robertsaabwoo/ttsky-analog-equalizer/docs/info.md

## How it works

This is a fully analog **600 Mb/s receiver front end**: an equalizer that undoes the loss of the chip's own
analog input path, followed by a clock-recovery loop that locks an on-chip oscillator to the incoming data
stream. There is no reference clock anywhere on the chip — the output clock is generated from the data itself,
which is why `clock_hz` is 0 and the harness `clk` pin is unused.

The signal path is `ua[0]/ua[1] -> CTLE -> CDR -> inverter chains -> uo[0]/uo[1]`, drawn in
`xschem/ctle_cdr_rx.sch`.

### 1. The CTLE (`xschem/CTLE.sch`)

A continuous-time linear equalizer: a differential pair with resistively and capacitively degenerated sources.
The degeneration network puts a zero below the data's Nyquist frequency, so the stage's gain *rises* with
frequency and cancels a channel that rolls off.

The channel it has to cancel is not an external cable — it is the **Tiny Tapeout analog pin path itself**,
which is specified at under 500 Ω of series resistance and under 5 pF of pad capacitance. That is a pole at
about 64 MHz, well below the 300 MHz Nyquist frequency of 600 Mb/s data, and it costs roughly 13.7 dB at
Nyquist. In simulation a 200 mV differential input arrives at the CTLE as only **64 mV** — the eye is
essentially shut at the pad before any circuit has touched it. The CTLE is therefore load-bearing, not an
optimization: it contributes about **+13.5 dB at Nyquist**, which very nearly exactly cancels the pin path.

### 2. The CDR (`xschem/CDR.sch`)

A reference-less **bang-bang (Alexander) clock-and-data-recovery loop**:

- an **Alexander phase detector** — four differential D flip-flops (eight `d_latch` stages) and two XORs —
  samples the equalized data on both clock edges and reports only whether the clock is *early* or *late*;
- that early/late decision drives a **charge pump** into a **loop filter**, producing a control voltage
  `vctrl`;
- `vctrl` tunes a **five-stage differential ring oscillator**, whose output is fed back to the phase detector
  as the sampling clock.

The loop settles when the oscillator runs at exactly the data rate with its edges centred in the data eye.
Because the phase detector is phase-only, the loop filter is deliberately about 10× smaller than a
comparable PLL's — a bang-bang CDR legitimately wants the higher loop bandwidth, and with PLL-sized
capacitors the control voltage drifts past the oscillator's usable range before the loop can acquire.

A small **startup precharge cell** (`xschem/vctrl_precharge.sch`) seeds `vctrl` into the oscillator's active
region for the first ~130 ns after power-up and then electrically removes itself. Without it, roughly half of
all power-ups never acquired lock — the outcome depended on the incoming data's polarity at power-on. The
seed is generated by a scaled replica of the ring oscillator's own tail device, so it tracks the oscillator
over process, voltage and temperature instead of being a hard-coded voltage.

### 3. Output buffering

Both recovered clock phases are buffered to pads through tapered inverter chains. The second phase on `uo[1]`
is not decorative: driving only one leg of a differential ring oscillator loads it asymmetrically.

Note that `uo[1]` is an *inverted and delayed* copy of `uo[0]`, not a true differential complement — it is
generated by passing the recovered clock through an inverter, so it carries that inverter's delay and
threshold offset. In simulation the two phases sum to the supply on average, but they have noticeably
different duty cycles (roughly 33 % and 61 % high). Do not build anything that assumes a 50 % duty cycle on
either output, or that the two are exactly non-overlapping.

### Simulated performance

Verified end to end (`xschem/tuning/e2e_ctle_cdr_tb.spice`) with data driven through a worst-case
500 Ω / 5 pF model of the analog pin path, at tt / 27 °C / 1.8 V. Section numbers refer to the design log
`xschem/tuning/ctle/NOTES_CTLE.md` (§C…) and `xschem/tuning/NOTES.md` (§…).

| quantity | value | source |
|---|---|---|
| data rate | 600.6 Mb/s (UI 1.665 ns) | §14 |
| recovered clock frequency | 600.64 MHz — a **full-rate** clock, one cycle per bit | §C23 |
| `vctrl` when locked | 0.791 V, the same point the CDR reaches alone (0.792 V) | §C23, §17e |
| signal at the CTLE input (after the pad) | 64 mV differential — the eye is shut at the pad | §C23 |
| signal at the CTLE output | 299 mV differential | §C23 |
| recovered clock swing | rail to rail (1.870 V) | §C23 |
| CTLE eye, worst PVT corner (ss / 125 °C / 1.62 V) | 174 mV, 0.350 UI | §C22 |
| combined channel + CTLE at Nyquist, 27 corners | −2.03 … +0.66 dB | §C18 |
| recovered clock period jitter, CDR alone on ideal data | 0.68 % UI RMS, 2.5 % UI pk-pk | §16b |
| recovered clock period jitter, full chain on PRBS7 | 18.45 ps RMS = 1.11 % UI; 6.70 % UI pk-pk | §C27 |
| sampling-phase error vs the ideal bit grid | 199 ps RMS = 11.96 % UI; 77 % UI pk-pk | §C27 |
| eye remaining at the sampling instant, nominal corner | mean 181 mV; 13 of 1201 samples within 25 mV of threshold | §C27 |
| startup precharge over 45 PVT corners | 45/45 pass, release 136-167 ns | §20a |

Those figures are for an alternating 0101 input, the easiest pattern for a bang-bang phase detector because
every bit is a transition. On a PRBS7 pattern — half the transition density, and runs of up to seven identical
bits — the loop still acquires, but it takes about **3× longer** (roughly 3 µs rather than 1 µs), overshoots
its final control voltage by ~37 mV on the way, and settles with ~2.8× the residual control-voltage ripple
(93.8 mV versus 33.7 mV). This is inherent to a bang-bang loop rather than a defect: each phase-detector
decision moves the control voltage by a fixed step (~17 mV here), and during a run of identical bits there are
no transitions, so the loop is briefly blind and phase error accumulates before it can be corrected. (§C25-B,
§C25-E)

Input amplitude matters: 200 mVpp differential at the pad is comfortable, and at 100 mVpp the signal path
still scales linearly but the loop wanders ±40 mV about its lock point. 100 mVpp should not be quoted as the
sensitivity limit — the actual limit has not been found. (§C25-D)

**Known limitations:**

- The ring oscillator cannot reach 600 MHz at 125 °C, or at a 1.62 V supply. The design is intended for room
  temperature and a nominal 1.8 V supply; this limit is characterised and accepted rather than fixed. (§20b)
- **Sampling-phase margin is thin.** §C27 measured it: phase error against the ideal bit grid is 0.120 UI
  RMS, against the ±0.175 UI of margin the 0.350 UI worst-corner eye allows — the eye edge is only about
  1.46σ away. At the nominal corner, 13 of 1201 samples land within 25 mV of the decision threshold. The
  loop frequency-locks exactly (0.011 %) with no cycle slips, so this is a margin question, not a
  functional one, but it is the risk that decides the link. The mechanism is the residual control-voltage
  ripple: 93.8 mV pp on a 357 MHz/V oscillator is ±16 MHz of instantaneous frequency.
- **Phase error at the worst PVT corner has not been measured**, only at nominal. That run — ss / 125 °C /
  1.62 V, where the eye is 0.350 UI rather than wide open — is the one that would decide whether this
  design closes. (§C27)
- **No PVT on the combined loop, and no layout**, so no extracted parasitics and no post-layout simulation.

## How to test

On hardware:

1. Hold `ua[2]` (`vbias`) at a steady **0.9 V**. A bench supply or a clean resistor divider is fine; it draws
   almost no current.
2. Drive `ua[0]` / `ua[1]` with a **differential 600 Mb/s** signal — a PRBS pattern or an alternating 0101
   pattern both work — with a common mode of about **0.9 V** and a swing of roughly **200 mV differential**.
   Keep the swing **below about 400 mVpp**: the input pair compresses above that, and a compressed input
   cannot be equalized.
3. Watch `uo[0]` on a scope or a fast counter. When the loop is locked it is a rail-to-rail square wave at the
   **bit rate** — about **600 MHz** for 600 Mb/s data, since this is a full-rate CDR. `uo[1]` should be its
   inverse, at the same frequency but not the same duty cycle.
4. Expect lock within a few microseconds of power-up: in simulation the loop settles in ~1 µs on a 0101
   pattern and ~3 µs on PRBS7, and it does not depend on which polarity the data happens to be in when the
   supply comes up (§C25-B, §C25-C).

Sweeping the input data rate slowly around 600 Mb/s and watching where `uo[0]` stops tracking maps out the
loop's lock range. Because the oscillator's reach is the limiting factor, expect that range to narrow as the
die heats up.

In simulation, the decks under `xschem/tuning/` reproduce all of the above; `e2e_ctle_cdr_tb.spice` is the
full chain and `xschem/tuning/ctle/` holds the equalizer-only AC, eye and PVT decks. All of them must be run through
`xschem/tuning/safe_ngspice.sh`, which caps memory and wall-clock time.

## External hardware

- A differential pattern generator (or two synchronized single-ended sources) capable of 600 Mb/s for
  `ua[0]` / `ua[1]`.
- A stable ~0.9 V bias reference for `ua[2]`.
- An oscilloscope with at least ~1 GHz of bandwidth, or a frequency counter, on `uo[0]`.
