robertsaabwoo/ttsky-analog-equalizer/(commit log)

2026-04-05 using custom VCO
    [CDR.sch, CDR_tb.sch, diff_amp_inv.sch, ring_inverter.sch, ring_oscillator.sch, ring_oscillator_tb.sch]
2026-04-05 slightly better
    [ring_inverter.sch]
2026-04-13 tuned closer to 300 MHz
    [CDR.sch, CDR_tb.sch, d_latch.sch, diff_amp_inv.sch, ring_inverter.sch, ring_oscillator.sch, ring_oscillator_tb.sch]
2026-07-21 Checkpoint: CDR sandbox locks in sim with 10x-shrunk (fake) loop-filter caps
    Preserves the first configuration where the bang-bang CDR loop frequency-locks
    in transient simulation: clk+ = 600.6 MHz, -0.02% vs the 600.6 MBaud data,
    rail-to-rail complementary clock, PD producing real bang-bang decisions,
    vctrl settling at 0.792 V.
    IMPORTANT — this locks ONLY because the loop-filter caps are 10x-shrunk
    (cap1 L=6->0.6, cap2 W=11->1.1), the sim-speed trick from NOTES.md §10. This
    is NOT a manufacturable configuration. With real (full-size) caps the loop
    FAILS TO ACQUIRE: from cold-start vctrl bleeds through the VCO dead-zone cliff
    (~0.65 V) before the phase-only Alexander PD can acquire, the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
    [CDR_tune.sch, CDR_tune_tb.sch, alexander_phase_detector_tune.sch, d_flip_flop_tune.sch, d_latch_tune.sch, diff_amp_inv_tune.sch, inverter_buffer_tune.sch, ring_inverter_tune.sch]
2026-07-22 Document §15: real-cap acquisition fails; root cause is architectural
    Source-follower clamp abandoned (run_A Rbot L=12: gate 1.225V -> vctrl
    collapsed to 0.53V, VCO dead). Near-vertical transfer, no manufacturable
    landing in the 0.65-0.9V window.
    Root cause: PLL blocks repurposed as a CDR deleted the reference+divider+PFD
    frequency-acquisition path. Bang-bang PD is phase-only. No reference clock is
    available (user-confirmed reference-less), so the tiny_pll PFD cannot be reused.
    Direction: validate the shrunk loop-filter caps as the legitimate CDR retune
    via a jitter measurement (§16, running overnight).
    [ring_inverter_tune.sch, tiny_pll_loop_filter_cap1_tune.sch, tiny_pll_loop_filter_cap2_tune.sch]
2026-07-22 Set shrunk-cap + R=23 config for jitter study (§16 branch)
    cap1 L=6->0.6, cap2 W=11->1.1 (10x shrink, §10 speed trick), ring R 23.5->23
    (proven §14 600.6 MHz lock point). This is the config whose jitter we validate
    to decide whether the shrunk caps are the legitimate CDR retune.
    [ring_inverter_tune.sch, tiny_pll_loop_filter_cap1_tune.sch, tiny_pll_loop_filter_cap2_tune.sch]
2026-07-22 §16: shrunk-cap jitter is small (0.68% UI RMS) — locks dead-on at 600.6 MHz
    Bang-bang hunting jitter on ideal 0101 data: 11.27 ps RMS (0.68% UI),
    41.12 ps pk-pk (2.47% UI), freq 600.616 MHz (+0.003%). Two-state limit-cycle
    dither, not numerical noise. Shrunk caps look like a legitimate CDR retune.
    Remaining threat: CID (0101 pattern has no transition runs). Add analyze_jitter.py
    (pure-stdlib jitter extractor from wrdata dumps). CID stress test next.
2026-07-22 §16e/f: shrunk caps PASS CID stress (runs 5/10/15 UI, never lose lock)
    During no-transition runs the VCO coasts <=1% off, vctrl drifts <20mV UPWARD
    (safe, away from the 0.65V cliff), loop recovers to 600.4 MHz within ~90 cycles.
    Shrunk caps validated as legitimate CDR retune (jitter + CID both pass).
    §16f watch item: cold-start acquisition is sensitive to the t=0 data seed (first
    CID attempt failed to acquire with opposite .op polarity). Polarity robustness
    test queued. Add cid_analyze.py.
2026-07-22 §16g: polarity test FAILS — cold-start acquisition depends on power-up polarity
    Opposite .op seed (vin+ starts HIGH): loop never acquires, vctrl stuck ~18uV,
    VCO dead the whole 1200ns. Only difference from the locking run is the polarity,
    so it's a real effect. Shrunk caps fix cap-size + pass jitter/CID, but cold-start
    is not polarity-robust (~50% power-up fail risk) -> a polarity-independent startup
    aid (precharge) is warranted even with shrunk caps. Ran safely under safe_ngspice.sh
    (no crash). Validating precharge fix next (§16h).
2026-07-22 §16h: precharge fix VALIDATED — vctrl startup seed makes cold-start polarity-independent
    Bad-polarity netlist + .ic v(x1.net1)=0.79 -> locks at 600.68 MHz (vctrl holds
    0.792, clk+ rail-to-rail). Seeding vctrl above the 0.65V cliff at power-up removes
    the polarity dependence. Complete session-6 picture: (1) architectural root cause,
    (2) shrink caps for cap-size acquisition (jitter+CID pass), (3) startup precharge
    for polarity-independent cold start. Remaining: build the real precharge one-shot.
2026-07-23 §17: add vctrl_precharge_tune — real POR one-shot startup precharge cell
    Replaces the §16h `.ic v(x1.net1)=0.79` proof-of-concept with an actual
    circuit, and instantiates it on the vctrl node in CDR_tune.
    Topology (9 devices):
    R1 (686k xhigh_po) + MCPOR (8x8 nfet gate cap) RC power-on ramp on nrc
    INV_A (nrc->pre), INV_B (pre->preb) one-shot, HIGH during hold
    MBP (enabled pfet source) + MBD (diode nfet) nbias = Vgs(MBD) ~ 0.79 V
    MSW (8/0.6 nfet) holds vctl at nbias
    MBD is a scaled replica of the ring tail M5, so the seed voltage tracks the
    VCO dead-zone cliff (~0.65 V) over PVT instead of being a fixed number.
    MSW opens before the b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
    [CDR_tune.sch, vctrl_precharge_tune.sch]
2026-07-23 §17e: real precharge cell VALIDATED in-circuit — bad polarity now locks at 600.631 MHz
    The exact §16g failing case, with the real vctrl_precharge_tune cell and NO seed
    on vctrl (only .ic on the POR cap, which is genuinely discharged at power-up):
    §16g bare loop vctrl 18 uV clk+ 6 mV never acquires
    §16h .ic v(vctrl)=0.79 vctrl 0.7921 clk+ 1.875 V 600.68 MHz (concept)
    §17 real cell vctrl 0.7918 clk+ 1.876 V 600.631 MHz <- PASS
    Cell seeds vctrl to 0.803 V, releases at 126.5 ns, loop then pulls to its own
    lock point 0.792 V and holds -- the loop wins after release, which is exactly
    what the §15 source-follower clamp could not do.
    Co-Author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
2026-07-23 §18: add PVT test suite for the precharge cell — built, not run
    xschem/tuning/pvt/ : gen_pvt.py + run_pvt.sh + collect_pvt.py + README.md.
    63 decks across three tiers, generated from the schematics (so they cannot
    drift) and gitignored. Nothing is executed by default.
    T0 ring open-loop f(vctrl) curve 11 decks ~12 min
    T1 cell alone, supply ramp, no .ic 45 decks ~8 min
    T2 full loop, bad polarity 7 decks ~2 h HEAVY
    Rationale for the split: the cell's hold level is a Vgs of the M5-replica diode
    and is designed to TRACK the dead-zone cliff, while t_rel is an R*C that tracks
    nothing and only has to stay in a window -- different tests break them. T0 exists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
2026-07-23 §19: fix CDR_tune_tb for GUI runs — .ic for the POR, save-limited raw, graphs
    The GUI testbench produced a dead clock (~5 mV swing) after §17 added the
    precharge cell. Cause: .op treats a cap as an OPEN, so the POR node nrc solved
    to Vdd, `pre` stayed 0, the one-shot never fired and vctrl seeded at 0.6634 V --
    exactly on the ~0.65 V dead-zone cliff. No oscillation -> no clock edges -> no
    PD output -> vctrl frozen. Reproduced: vctrl pp 4.4 uV, clk_pp 6.096 mV.
    This is the GOOD polarity, which locked WITHOUT a precharge in §16b: adding the
    cell moved the DC operating point onto the cliff via MSW's subthreshold path to
    nbias. So .ic is now mandatory for this deck -- a sim artifact (silico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
    [CDR_tune_tb.sch]
2026-07-23 §20: T0+T1 PVT results — cell passes 45/45; ring temperature limit ACCEPTED
    Ran both cheap tiers (T2, ~2 h, still not run).
    T1 precharge cell: 45/45 PASS. Seed 0.693-0.908 V, release 136-167 ns, across
    MOS {tt,ss,ff,sf,fs} x T {-40,27,125} x VDD {1.62,1.80,1.98} x RC {typ,hh,ll},
    self-starting from a real supply ramp with no .ic anywhere. The M5-replica bias
    does track the cliff as designed. t_rel is far more stable than expected (±10%)
    because MCPOR is a MOS gate cap, so the PDK cap corners do not touch it.
    Tightest margin is 31 mV at ff/-40C, with a caveat about T0's coarse resolution.
    T0 VCO tuning range: 6 pass / 5 fail. At 125C the curve saturates above 0.85 V,
    so the ring is RC-l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
2026-07-23 CTLE §C1-C10: characterize the CTLE and retune it into a real equalizer
    The block as drawn is not an equalizer. Its degeneration zero (~790 MHz, set
    by a 597 ohm res_high_po against 338 fF) lands on top of its own output pole,
    so the two cancel and CTLE.sch is a flat 10.35 dB differential amplifier with
    +0.00 dB of boost. Confirmed CTLE.sch is byte-identical on all seven branches
    and has one commit ever, so there is no better variant to recover.
    Retune, in the sandbox copy CTLE_tune.sch:
    - the two degeneration MIM caps (13x13 each, to the tail) become ONE 18x18
    cap bridging the two source nodes. Differentially that is 2C per side for
    half the area -- 4x the area efficiency, 1.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
    [CTLE_tune.sch, CTLE_tune_tb.sch]
2026-07-23 CTLE §C10-C14: boost ladder, 1 Gb/s, and the chain interface check
    Boost ladder (ladder.spice, 48 sizings x 3 channels in one AC run; eye3.spice,
    9 sizings x 3 channels in eyes). Two results:
    - There is a ceiling. This topology supplies at most ~5-6 dB of boost, so a
    channel losing more than ~6 dB at Nyquist cannot be flattened by one stage,
    only softened. The 4 pF channel (11.8 dB at Nyquist) bottoms out at ~4 dB
    of residual ripple no matter how it is sized.
    - The ranking inverts with channel loss, so the sizing is a real choice, and
    C10 is now an answer table: mild channel -> Ldeg 1.5 / Wcap 18 (what
    CTLE_tune.sch holds); unknown channel -> Ldeg 3.0 / Wcap 21 i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
    [subckt_src.sch]
2026-07-23 CTLE: PVT-qualify the minimax sizing too, so switching needs no re-run
    ac_corner_mm.spice runs Ldeg 3.0 / Wcap 21 over the same 27 corners as the
    primary sizing: DC gain +6.93..+8.34 dB, boost +4.35..+5.97 dB, gain at Nyquist
    +8.04..+11.40 dB. Equally PVT-stable; it just over-equalizes the mild 1 pF
    channel on purpose. Both candidate sizings are now qualified, so choosing
    between them is a channel question only.
2026-07-24 CTLE §C15-C21: the channel is the TT pin — retune against 500Ω/5pF
    The blocking question from §C14 is answered: the channel is not external, it
    is the Tiny Tapeout analog pin path itself, spec'd at <500 Ω and <5 pF.
    That bound puts the pole at 63.7 MHz, 4.7x below Nyquist, and at 600 Mb/s the
    eye is FULLY CLOSED at the pad (-5 mV, 0.000 UI). Every channel measured up to
    §C14 was milder than the guaranteed worst case, so the old sizing was tuned for
    the wrong thing — on the real channel it recovers only 46 mV / 0.090 UI.
    Retuned to Win 20 / Lload 20 / Ldeg 5.0 / Wcap 18: 232 mV / 0.430 UI on the
    spec-worst channel, 5x the height and 4.8x the timing margin, at the same MIM
    area and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
    [CTLE_tune.sch]
2026-07-24 HANDOFF §6: point at the TT-pin channel result and the final CTLE sizing
2026-07-24 CTLE §C22: run the eye at the PVT extremes, not just AC
    C18 qualified the corners in AC only. The actual PRBS7 eye at ss/125C/1.62V is
    174 mV / 0.350 UI -- it never closes, and 0.350 UI is the number the rest of the
    chain should be designed against.
    Also exposes that the output common mode moves 362 mV over the corner box, which
    D2S_amp is DC-coupled to and has never been checked against.
    Records a trap that silently invalidated the first attempt: ngspice's 'reset'
    discards instance 'alter's but keeps 'alterparam', so a corner loop using
    'set temp'/'alter VDD' returned identical numbers for every corner with no
    warning.
2026-08-02 main: archive sim tools/decks + STATUS note; gitignore sim outputs
    Bring loose infrastructure onto main alongside the fast-forwarded CDR work
    (§16-20): the check_swing.sh / jitter.py tools, the baseline sim decks, the
    xschem design README, and a STATUS.md documenting the new branch layout and
    the fact that the promoted real design files still carry pre-validation tuning
    (the validated design lives in tuning/; stale hand-edits were stashed).
2026-08-02 main: archive pre-sandbox scratch/reference schematics
    Non-empty experimental and reference schematics from before the tuning/ sandbox
    era (the original tiny_pll blocks the CDR was derived from, early testbenches,
    inverter/latch experiments). Kept for history. Excluded deliberately: empty
    68B templates (untitled.sch, demux_tbsch, alexander_single.sch) and the
    abandoned LA_Limiter (see xschem/STATUS.md).
    [CDR_single.sch, TSPC_Latch.sch, demux_tb.sch, diff_savefile.sch, double_inverter.sch, full_tb.sch, inverter_buffer.sch, just_in_case.sch]
2026-08-02 CTLE §C23: end-to-end CTLE+CDR locks through the pad LPF (merge gate)
    First simulation of the CTLE and CDR as one loop. 200 mVpp diff data through the
    500ohm/5pF TT pad LPF on both legs -> CTLE_tune -> CDR_tune. The pad crushes the
    eye to 64 mV; the CTLE equalizes it back to 299 mV diff; the CDR locks at
    600.64 MHz / vctrl 0.791 V (= the standalone lock point), rail-to-rail recovered
    clock. Physics closes: ~13.5 dB CTLE gain vs ~13.7 dB channel loss at Nyquist.
    Subckts harvested from a FRESH CDR_tune_tb.sch netlist (the stale untracked one
    lacked the x20 precharge + variant-E clock). Open before merge: measure rclk-,
    both polarities, PRBS/CID through the CTLE, PVT. See NOTES_CTLE §C23.
    C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
2026-08-15 Promote the validated CDR+CTLE into the real design, and wire it to TinyTapeout
    The tuning/ sandbox has been the real design since NOTES 14/16/17 and
    NOTES_CTLE C17/C20/C23; the files at xschem/*.sch were still the known-wrong
    300 MHz plan from c9ee560. This promotes every validated block into its real
    name and rewires the project around it.
    Promotion (verified at NETLIST level, not by eye): CDR.sch was re-netlisted and
    compared against the validated tuning/e2e_blocks.inc -- all 17 leaf subcircuits
    match exactly, with an identical top-level instance list. Every promoted block
    was checked to be pin-identical first, so each was a wholesale file copy plus a
    rewrite of the internal *_tune.sym r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
    [CDR.sch, CTLE.sch, ctle_cdr_rx.sch, ctle_cdr_rx_lvs.sch, d_latch.sch, diff_amp_inv.sch, inverter_buffer.sch, ring_inverter.sch]
2026-08-15 project.v: fix power-pin direction on the ctle_cdr_rx blackbox
    verilator caught it: the blackbox declared VDPWR/VGND as inout while the TT
    top module receives them as input, which is an ASSIGNIN error. Lints clean now.
    [project.v]
2026-08-15 Move to a 2x2 tile, and stack the C25 end-to-end batch to run unattended
    Tile: the promoted design is ~166 transistors plus 43 long poly resistors
    (res_high_po L=20-23 um each) and a MiM cap. 1x2 (161 x 225.76 um) was chosen
    back when this was the CTLE->latch chain and is now too tight, so info.yaml and
    mag/Makefile move to 2x2 (334.88 x 225.76 um). The .def itself stays out of git
    (mag/.gitignore ignores *def); the Makefile has the wget rule.
    Three traps found while doing it, all written into mag/README.md:
    - the 1x2 and 2x2 .def files are IDENTICAL except for DIEAREA and the
    standard-cell ROWs. Same pins, same positions. So `make start` draws the
    same frame either way and the .m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
2026-08-15 Measure the actual area budget: 1162 um2 drawn, so area was never the constraint
    Flattened the ctle_cdr_rx netlist: 216 transistors, 43 poly resistors, 1 MiM
    cap, 1162 um2 of drawn device area. Even at a 5x hand-layout multiplier that is
    ~5800 um2 against 36 347 um2 in a 1x2 tile.
    This contradicts the 'plausible but tight' framing I gave when proposing the
    move to 2x2 -- 1x2 would have fit with room to spare. 2x2 still stands on
    layout comfort (matched ring placement, guard rings, routing channels), but
    mag/README.md now records that it is a comfort choice, not a necessity, and
    that reverting is a two-line change.
    Also records what actually shapes the floorplan rather than the area total: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
2026-08-15 Correct the CDR.sym pin-change assessment, and write a real root README
    The vbias pin change was assumed to have made full_tb.sch and demux_tb.sch
    stale. Checked properly: it did not. The six pre-existing pins sit at IDENTICAL
    coordinates in the old and new symbol -- only the listing order in the file
    differs -- and the new vbias pin landed on a previously unoccupied spot that
    both testbenches already had a vbias wire routed to. The promotion completed
    that connection rather than breaking it. Verified by netlisting full_tb:
    x1 Vdd Vss vin+ net1 vbias net4 net3 CDR
    No testbench edits needed. STATUS.md corrected.
    Root README was still the unedited TT template ('[IN PROGRESS] Tiny Tapeou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
2026-08-15 C25-A: the 0101 control settles to 0.2 mV, and a mechanism for the PRBS drift
    C25-A (the A/B baseline C24 lacked) is locked beyond argument: vctrl is
    0.79139 / 0.79160 / 0.79150 / 0.79160 V across four windows -- 0.2 mV of spread
    over 1.8 us -- at 600.577 MHz against 600.6 Mb/s data. It also reproduces C23
    exactly (63.7 mV in, 298.3 mV out, 33.7 mV ripple) FROM THE PROMOTED REAL
    FILES, which independently confirms the netlist-level promotion check.
    It also settles the rclk- question: rsum_pp is 2.218 V here too, in a perfectly
    locked loop on the easiest possible pattern. The duty-cycle asymmetry is
    structural (the single_inverter), not a symptom of failing to settle.
    Mechanism for the C24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
2026-08-15 Queue a direct test of the C25 charge-pump mismatch hypothesis
    cp_mismatch.spice holds the charge pump's output at a forced voltage and reads
    the current for all four (up,down) states across the usable vctrl range. The
    number that matters is icp_both: on the C25 analysis, up==down==1 during a CID
    run turns both legs on and leaves the mismatch flowing onto the filter. If that
    is ~1.7 uA it quantitatively explains C24's 161 mV excursion over a 7-UI run on
    ~120 fF of cap1.
    Four .dc sweeps -- seconds, not minutes. Wiring of x_bias and x_cp was checked
    pin-for-pin against how CDR.sch instantiates them, including that the pump's
    `up` is the PD's `up` and not the inverted one.
    run_after_batch.sh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
2026-08-15 C25-B: the merge gate PASSES -- C24's "not settled" conclusion was premature
    C24 stopped the PRBS7 run at 2 us, saw vctrl at 0.828 V and still moving, and
    concluded the loop was still acquiring. It had caught the loop at the peak of
    an overshoot. Run to 3 us it is a damped ring, not a runaway:
    1.0-1.1 us 0.79109 V
    1.8-1.9 us 0.82811 V +37.0 mV <- where C24 stopped
    2.4-2.5 us 0.80188 V -26.2 mV
    2.8-2.9 us 0.79921 V -2.7 mV
    The first two windows reproduce C24 to seven significant figures, so this is
    the same trajectory continued rather than a different run, and the log confirms
    it reached 2.99999e-06.
    What PRBS7 actually costs against 0101: ~3x the acquisition time (3 u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
2026-08-15 C25-C: polarity is fine; the STILL MOVING flag and the frequency are not trustworthy
    C23 gap 2 is answered and the answer is good: precharge release is 126.49 ns
    against B's 126.56 ns, cin_swing is identical to four figures (183.3 mV both),
    and both polarities converge into the same 0.799-0.801 V region. Inverting data
    cannot move transitions, so the PD is indifferent in steady state; what differs
    is the acquisition path, B overshooting to 0.828 and ringing down while C creeps
    up from 0.788.
    Two measurement problems, both mine, recorded so they are not repeated:
    - the 5 mV verdict threshold in run_c25.sh is arbitrary and separates B
    (2.7 mV) from C (6.9 mV) on a difference that means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
2026-08-15 Queue C26: measure jitter through the chain, the risk C25 left standing
    C25-B showed the loop settles on PRBS7 but with 93.8 mV pp of residual vctrl
    dither. That only matters if it walks the sampling instant out of the 0.350 UI
    the CTLE delivers at the worst PVT corner (C22) -- and vctrl dither is not
    phase error. This measures phase error directly.
    e2e_c26_jitter.spice is the C25-B chain with the recovered clock written out so
    edge times can be compared against the ideal bit grid. jitter_parse.py finds the
    0.9 V crossings by interpolation and reports cycle-to-cycle jitter plus the
    residual against a best-fit clock, which is the quantity that eats eye margin.
    Two things carried over delibe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
2026-08-15 C25-D: 200 mVpp is comfortable, 100 mVpp is marginal
    The signal path scales linearly -- 183.3 -> 91.6 mV at the CTLE input (exactly
    2x) and 667.8 -> 347.9 mV at its output -- which confirms the CTLE is in its
    linear region at both levels per C8, with no compression. Clock still
    rail-to-rail, precharge still releases at 126.5 ns.
    The loop, though, wanders: vctrl goes 0.7925 / 0.7951 / 0.8335 / 0.7978 across
    the four windows. That is +38 then -36 mV between adjacent windows with w4 back
    near w1 -- a large low-frequency wander about the lock point, not a drift and
    not a decaying ring. Nothing like it at 200 mVpp.
    Likely cause: 348 mV differential is about half the swing the PD latches see at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
2026-08-15 C25-E: measured the charge pump -- my CID mechanism is refuted, off by 80x
    cp_mismatch.spice at the 0.791 V lock point:
    both legs OFF 44.9 pA <- clean, as predicted
    UP only +1.263 uA
    DOWN only -1.284 uA
    both ON -20.6 nA <- 1.6% of the leg current
    The structural half of C25 was right (both-off is clean, both-on leaves a
    residual). The quantitative half was badly wrong: 20.6 nA over a 7-UI run on
    121 fF moves vctrl 2.0 mV, against the 161 mV observed in C24. The hypothesis
    accounts for 1.2% of the effect. The charge pump is well matched and is NOT the
    problem -- nothing about the taped-out block needs to change.
    What actually sets the dither is plain ban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
2026-08-15 C26: cycle-to-cycle jitter is fine; the phase-wander measurement is not usable
    Cycle-to-cycle is believable and acceptable: period RMS 24.59 ps = 1.48% UI,
    pk-pk 128.81 ps = 7.74% UI. That is ~2x NOTES 16b's 0.68% UI for the CDR alone
    on ideal full-rail data, which is a plausible cost for real data through a
    channel that closes the eye at the pad.
    The parser also reports 33.8% UI RMS phase error against a best-fit clock. That
    number should NOT be quoted, for three reasons: the window still contains
    settling (vctrl is 0.8019 V at 2.4 us and 0.7992 V at 2.8 us); a best-fit
    constant-period clock is the wrong reference for a CDR, which tracks the DATA;
    and bang-bang CDRs have unbounded low-freq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
2026-08-15 Fix the C26 deck properly: my sed left dangling e1800 references
    The previous commit's sed inserted the warning comment but left both let
    statements still referencing e1800, plus a duplicate e1740 measure. Now uses
    e1200/e1680/e1740 consistently: 540 cycles for the averaged figure and 60 for
    the deliberately-short comparison.
2026-08-15 Add mag/LAYOUT_HANDOFF.md — a self-contained brief for a layout session
    The schematic design is frozen, netlist-verified and the LVS toolchain is proven
    to run, but nothing has been drawn. This is everything a session dedicated to
    layout needs, in one file, so it does not have to reconstruct it from the design
    logs.
    Contents: what the macro is and its pad mapping; current state (empty 2x2 frame,
    make lvs runs and correctly flattens 224 devices on the source side); the exact
    toolchain commands including that the _lvs WRAPPER must be netlisted, not the
    macro; a per-block device inventory with drawn areas; floorplan guidance; the
    hard constraints; the traps already hit; and the open items th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
2026-08-15 c25_summary.txt: add the two results the killed waiters never appended
    The file was committed as the evidence behind NOTES_CTLE C25-C26 but contained
    only decks a-d. The charge-pump mismatch measurement and the C26 jitter run were
    executed manually, after both queued waiter scripts were killed -- their
    `pgrep -f run_c25.sh` guard matched the agent's own shell, whose command line
    contained the script text from the heredoc that created it, so they would have
    waited forever. So neither appended its results.
    Both are now in the file, with the caveats attached rather than left to the
    reader: that the charge-pump hypothesis is refuted by its own measurement, and
    that C26's phase-wander numbers mu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
2026-08-15 Move unused schematics to xschem/attic/ so the top level is only the chip
    xschem/ had 52 .sch files with no indication of which mattered. It now contains
    exactly the 22 cells reachable from ctle_cdr_rx_lvs.sch, computed from the
    actual instantiation graph rather than by eye.
    The other 30 (43 files with their .sym) moved to attic/: CDR and CTLE
    testbenches, the old D2S_amp output chain, the demux experiments, the ring/VCO
    benches, and the original TinyTapeout PLL blocks the CDR was derived from.
    Moved rather than deleted because tuning/NOTES.md, NOTES_CTLE.md, STATUS.md and
    README.md cite them throughout -- deleting would leave the design logs pointing
    at nothing.
    attic/ is added to XSCHEM_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
    [CDR_single.sch, CDR_tb.sch, CTLE_WITH_LATCH.sch, CTLE_testbench.sch, D2S_amp.sch, LA_Limiter.sch, TSPC_Latch.sch, alexander_loop.sch]
2026-08-15 Add mag/MAGIC_GUIDE.md and a per-cell LVS tool for hand layout
    MAGIC_GUIDE.md is the hands-on counterpart to LAYOUT_HANDOFF.md: the mental
    model, a 22-step build order from single_inverter up to the padded top, the exact
    device list for every leaf cell, the design-specific matching requirements, a
    Magic command cheat sheet, and a concrete first session.
    lvs_cell.sh extracts ONE cell and compares it against the same cell in the xschem
    netlist. `make lvs` only checks the whole chip, which is useless while building --
    this makes it possible to verify each block the moment it is drawn.
    Running it on the half-finished d_latch.mag left by an earlier session gives a
    useful worked example, so the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
2026-08-20 Fill in info.yaml author; stop the gds workflow failing before layout exists
    info.yaml carried `author: ""` with a literal "TODO: fill in" comment.
    The gds workflow built from gds/<top>.gds and lef/<top>.lef, neither of which
    exists because layout has not started, so every push produced a red run and a
    red badge for work that legitimately has not been done. It now resolves the top
    module, checks whether the GDS is actually there, and skips the build/precheck/
    viewer jobs with a GitHub notice if it is not. No GDS is faked: the moment
    `mag/ make update_gds` writes the files, the full TinyTapeout flow runs again
    with no further edits.
    Clau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
2026-08-20 Add a repository-consistency test suite and run it in CI
    test/ contained only a requirements.txt and no tests. This adds 43 fast tests
    that need no PDK, no simulator and no network, so they run on a stock ubuntu
    runner via the new test workflow:
    * info.yaml vs src/project.v vs mag/: top module name, the standard TT port
    list, tiles, analog_pins vs the documented ua[] entries, which uo_out bits
    are actually driven, PROJECT_NAME and the magic top cell, no template
    markers left.
    * the frozen xschem hierarchy walked from ctle_cdr_rx.sch: every symbol
    resolves in xschem/ or xschem/attic/, every symbol has a schematic, the
    expected blocks are still instantiated, instance n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
2026-08-20 Surface the measured results; make the README state what is and is not done
    The engineering in NOTES.md / NOTES_CTLE.md was buried three directories deep.
    README.md: replace the broken gds badge with the test badge, add a "State of
    the project" table (works / verified / not done / known limitation) and a
    measured-results table where every row cites the design-log section it came
    from. Numbers are quoted only where a log records them; the unmeasured
    sampling-phase jitter and the unrun combined-loop PVT are listed as "not
    measured" rather than omitted. Bigger ASCII signal-path diagram, corrected
    NOTES_CTLE range (it runs to C26, not C25), and a section on the test suite.
    docs/DESIGN.md (new)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
2026-08-20 Rewrite xschem/README.md; ignore unrelated scratch
    xschem/README.md still ended with a "Current CDR status" section reporting that
    the recovered clock does not swing (52 mV pk-pk, pinned near the rail) and a
    "leading hypothesis" for why -- a diagnosis from before the loop worked, kept
    behind a "much of the text below is history" disclaimer. On a public repo the
    disclaimer does not help: the last thing a reader sees is a broken circuit and
    a file inventory listing schematics that now live in attic/.
    Rewritten around the current design: the top-level and CDR pin tables, the
    loop block diagram with the real instance names (x3/x6/x8/x2/x1/x4/x11/x12/x20),
    why the loop filter is 10x smaller than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
2026-08-21 Add measured figures, calibrate the analysis tools, restructure the README
    The repo had zero images. For a project whose case rests on measured results
    that was the largest presentation gap, so four figures are now generated from
    data already on disk -- no simulation was re-run, and numpy/matplotlib are not
    installed, so docs/tools/svgplot.py emits the SVG directly.
    docs/img/block-diagram.svg hand-authored signal path; the only numbers on
    it are measured values, each cited
    docs/img/eye-before-after.svg PRBS7 eye at the pad, through the as-drawn
    CTLE, and through the retune, from
    ctle/eye2_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
2026-08-21 Add a real-number receiver model, and the C27 jitter measurement C26 got wrong
    Three things, all of which were open items rather than new scope.
    1. model/ -- a real-number behavioural model of the CTLE+CDR macro, plus a
    self-checking testbench. The only Verilog in the project was the blackbox
    wrapper in src/project.v, which is correct for tapeout but means the
    receiver cannot be closed into a link simulation at all; a SPICE deck of
    this chain costs ~7-20 minutes, the model runs in seconds.
    Every constant is measured and cites its log section, except the loop
    filter R and C, which are labelled FITTED, NOT MEASURED because they are
    chosen to reproduce the 93.8 mV pp ripp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
    [rx_cdr_rnm.sv, tb_rx_cdr.sv]
2026-08-21 README: surface the behavioural model and the simulation traps
    Both were added in the previous commit but were only reachable by browsing the
    tree. The model section leads with the cross-check that matters -- the RNM and
    the SPICE netlist independently agree on the control voltage at lock -- and is
    explicit that the model understates jitter and is never the source of a jitter
    number.
    Claude-Session: https://claude.ai/code/session_01JkUqPFwg39HQXTHdKCFY9p
2026-08-21 C27: measure the jitter properly. The sampling-phase margin is thinner than assumed
    The run C26 asked for and never got. 6 us, 324663 points, 1201 rising edges in a
    settled window, all three of C26's defects fixed: the window is genuinely
    settled (proven in the deck by three separated averaging windows that agree to
    6.4 mV against 61.8 mV of ripple -- dither, not drift), phase is referenced to
    the ideal 1665.00 ps grid rather than a best-fit clock, and the CTLE output is
    dumped alongside the clock so the eye consumed at the sampling instant is
    measured rather than inferred.
    Good news first. Cycle-to-cycle jitter is BETTER than C26 reported: 18.45 ps
    RMS = 1.11 % UI, not 24.59 ps = 1.48 %. C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
2026-08-21 Confirm the C27 sampling-margin finding, and find the sharper version of it
    The C27 result is unflattering, so it was checked before being left standing as
    a public claim. Same rawfile, no re-simulation.
    The worry was specific and would have invalidated it. An Alexander detector
    samples on BOTH clock edges -- one in the eye, one on the data crossing -- and
    rclkp is the buffered OUTPUT pin, downstream of the output inverter chain,
    rather than the detector's internal sampling clock. If the buffer delay had put
    the measurement near a crossing, small |coutp-coutm| values would be correct by
    design and the finding would be an artefact.
    Sweeping the sampling phase across a full UI settles it: ta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
2026-10-12 Make the notes agree on jitter: period jitter, not cycle-to-cycle; sampling phase is measured
    - Every published jitter figure (0.68 % §16b, 1.48 % §C26, 1.11 % §C27) is
    the RMS of the clock period. README, info.md, DESIGN.md, HANDOFF and the
    NOTES_CTLE headings called it cycle-to-cycle; relabelled, numbers unchanged.
    c27_analyze.py and jitter_parse.py now print the right name.
    - DESIGN.md and LAYOUT_HANDOFF still said the sampling-phase error was
    unmeasured; §C27 measured it (11.96 % UI RMS, 13 of 1201 samples within
    25 mV of the threshold).
    - HANDOFF's numbers table now says which stimulus each figure is for.
    - .gitignore: docs/INTERVIEW_QA.md is a personal file.
    Co-Authored-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
